Shriya1503/AI-Water-Classifier/Assets/5VboostConvertor.jpg

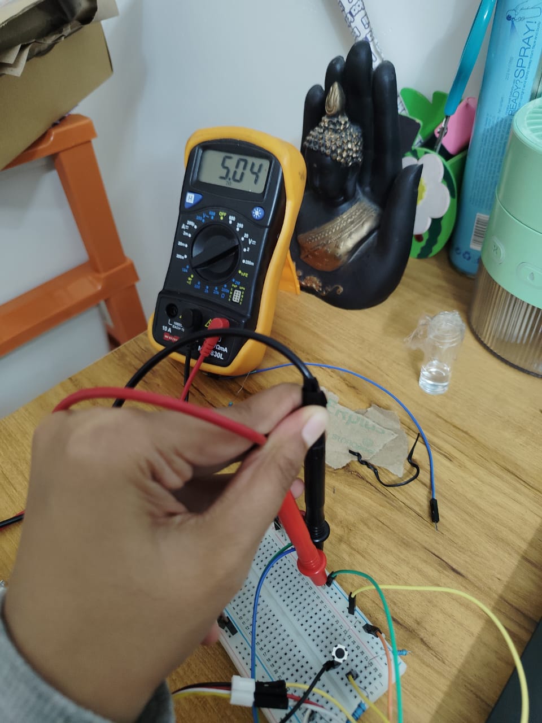
Assets/5VboostConvertor.jpg
