Shriya1503/AI-Water-Classifier/Assets/TubidityHack.jpg

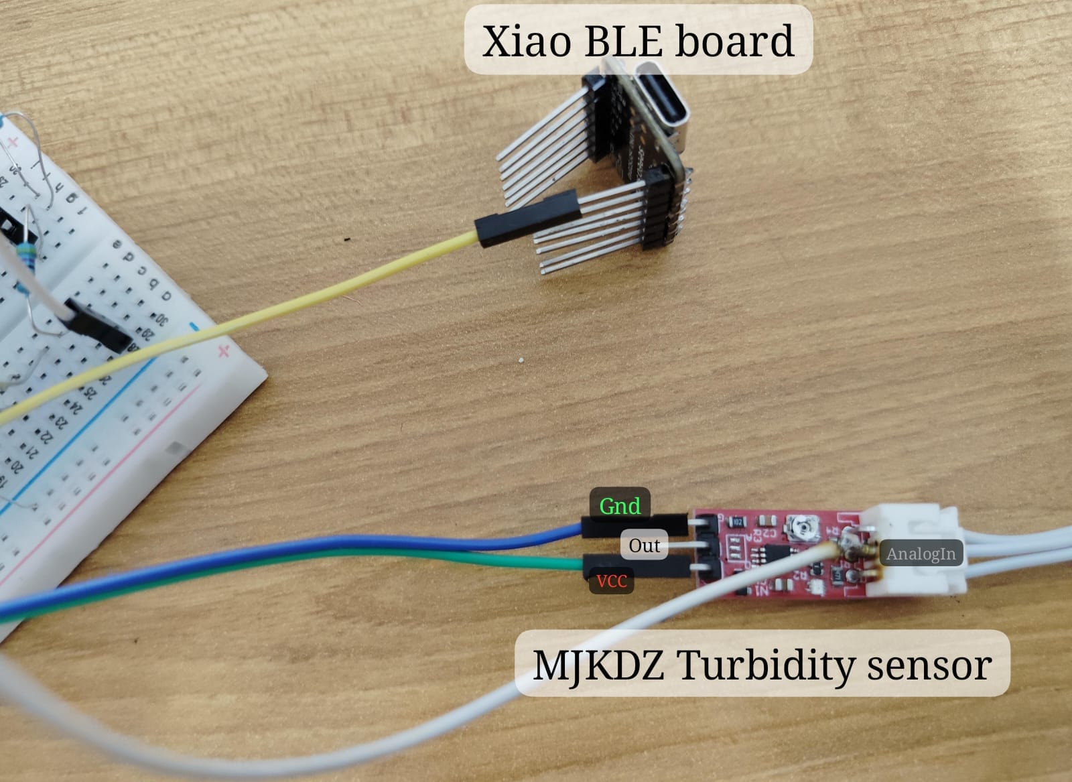
Assets/TubidityHack.jpg
