Shriya1503/AI-Water-Classifier/Assets/WebAppDasboard_Safe.jpg

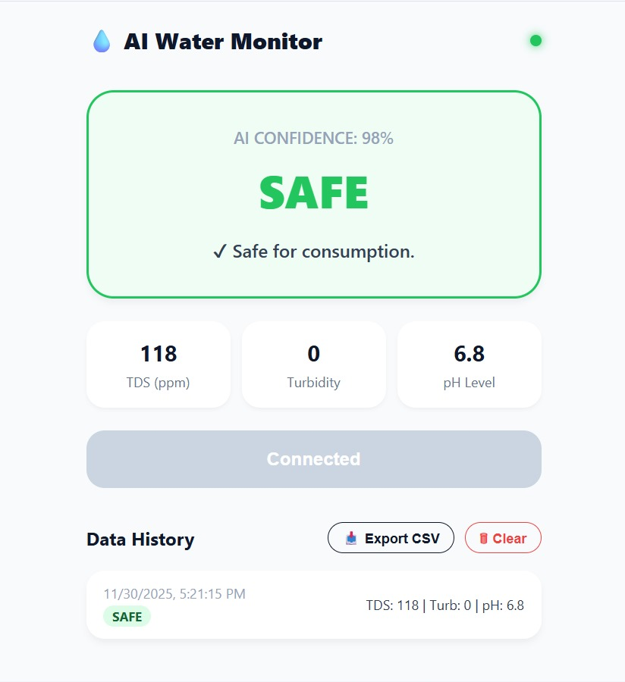
Assets/WebAppDasboard_Safe.jpg
