Shriya1503/AI-Water-Classifier/Assets/WebAppDasboard_Tap.jpg

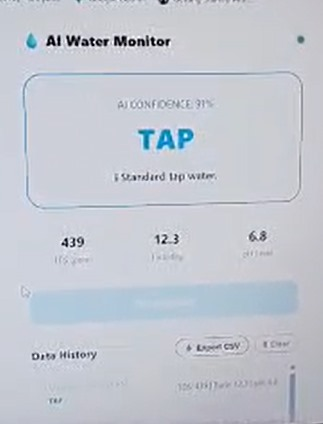
Assets/WebAppDasboard_Tap.jpg
