Shriya1503/AI-Water-Classifier/Assets/WebAppDasboard_Unsafe.jpg

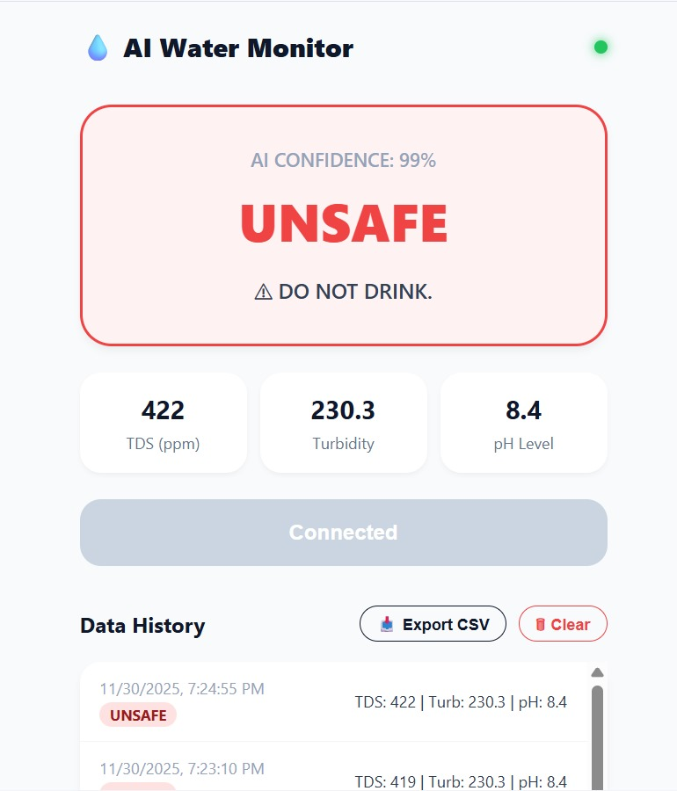
Assets/WebAppDasboard_Unsafe.jpg
