Shriya1503/AI-Water-Classifier/(commit log)

2025-11-30 Create FinalBLE_AI_Water_Classifier
    Copy paste this code in Arduino IDE and save the sketch.
    Remember to include the ML Model i.e AI_Water_Classifier_inferencing.h in library manager.
2025-11-30 Final +Indivisual Sensor codes
2025-11-30 Edge Impulse Model
    Include this zip file as library in Arduino IDE. Goto examples of this library and find the package name, here it is--> #include <AI_Water_Classifier_inferencing.h>
